ErwanVercruysse/arachne-18/bam_data/swing/2026-09-27_13h23m52_60g_plus_side_clipped/plot.png

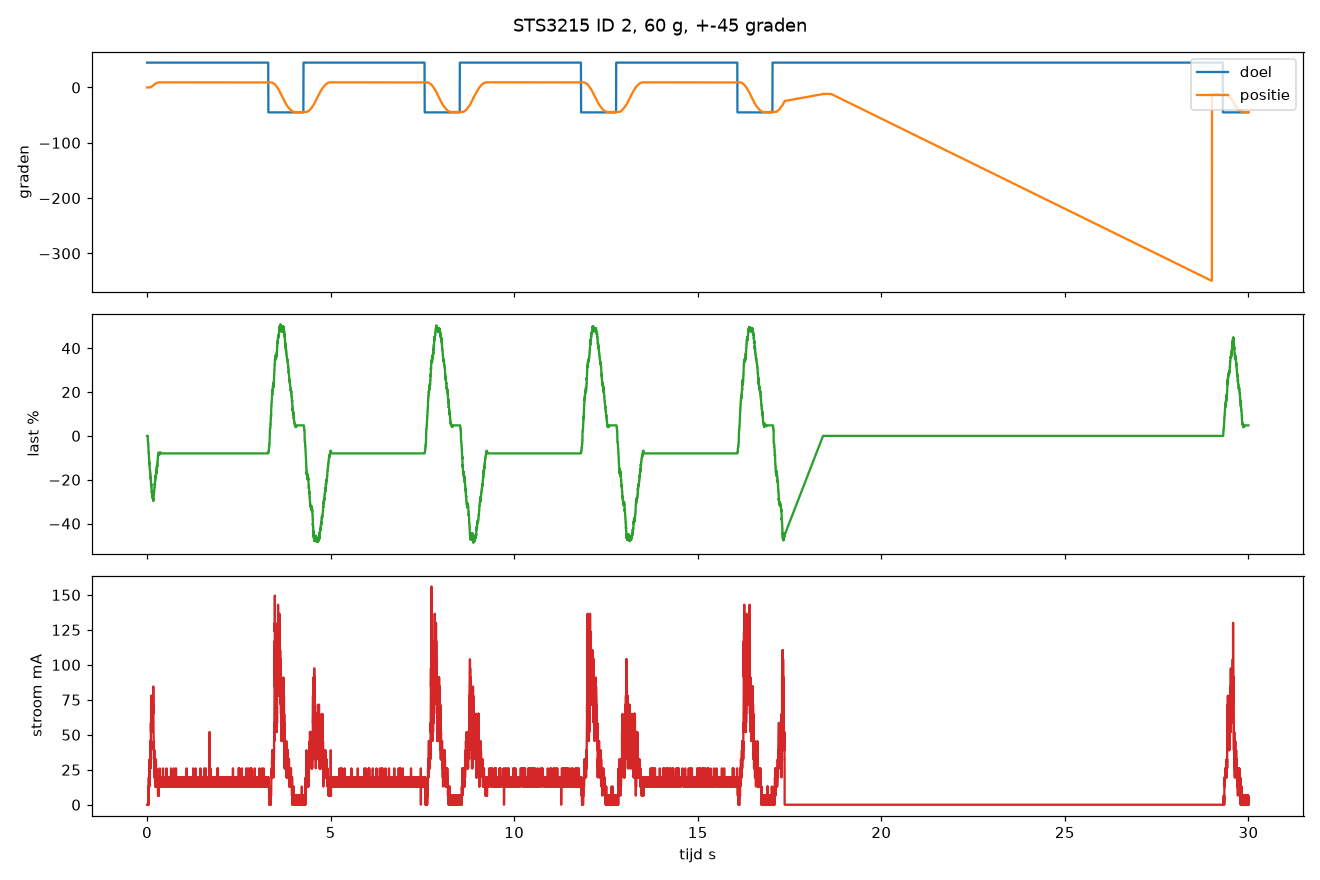
bam_data/swing/2026-09-27_13h23m52_60g_plus_side_clipped/plot.png
