ErwanVercruysse/arachne-18/bam_data/swing/2026-09-27_13h28m05_60g/plot.png

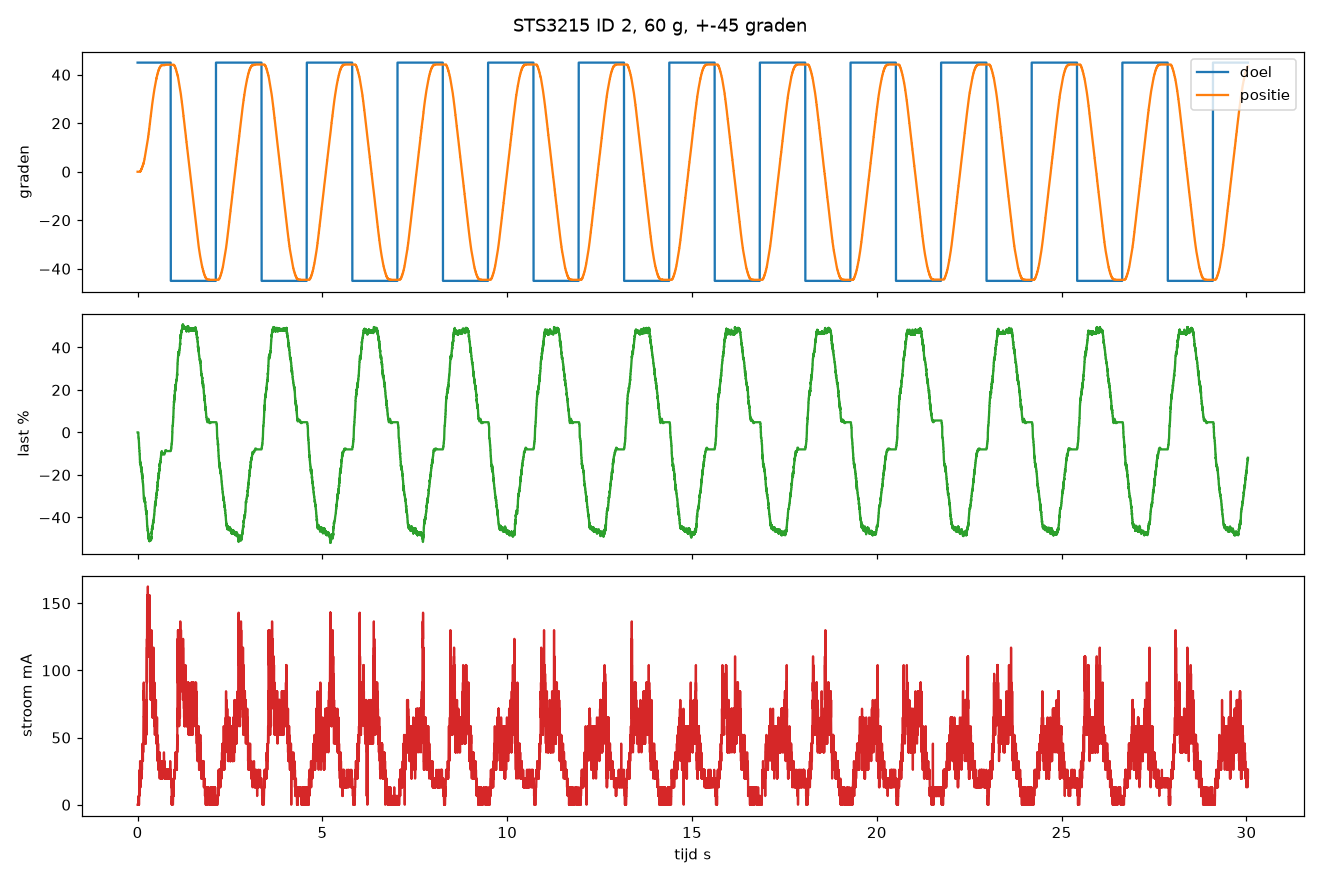
bam_data/swing/2026-09-27_13h28m05_60g/plot.png
