ErwanVercruysse/arachne-18/bam_data/swing/2026-09-27_13h29m40_60g_lift90_WRONG_DIRECTION_STALL/plot.png

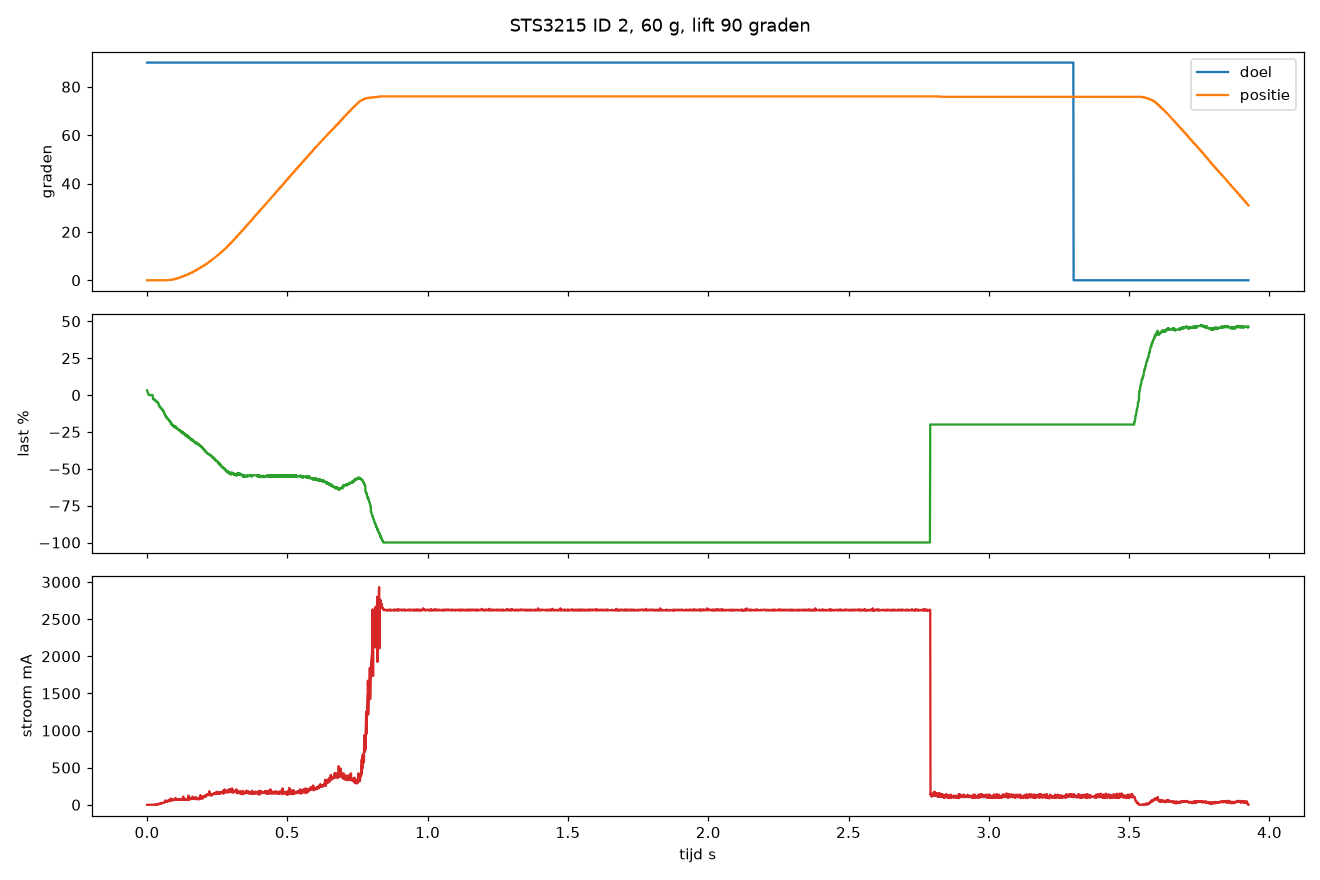
bam_data/swing/2026-09-27_13h29m40_60g_lift90_WRONG_DIRECTION_STALL/plot.png
