ErwanVercruysse/arachne-18/bam_data/swing/2026-09-27_13h41m15_38g_between-95_POWER_CUTOUT/plot.png

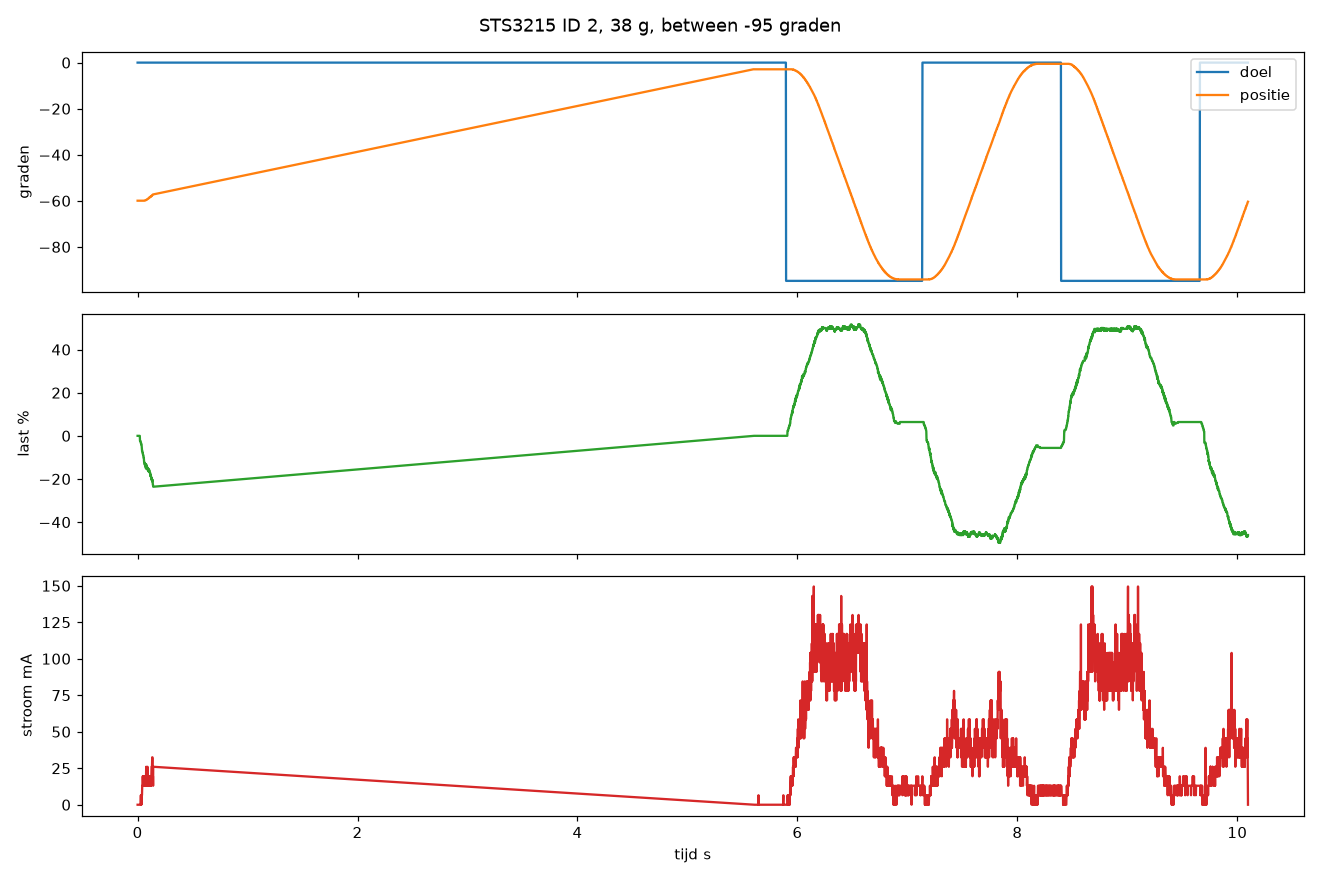
bam_data/swing/2026-09-27_13h41m15_38g_between-95_POWER_CUTOUT/plot.png
