ErwanVercruysse/arachne-18/bam_data/swing/2026-09-27_13h56m46_123g_between-95/plot.png

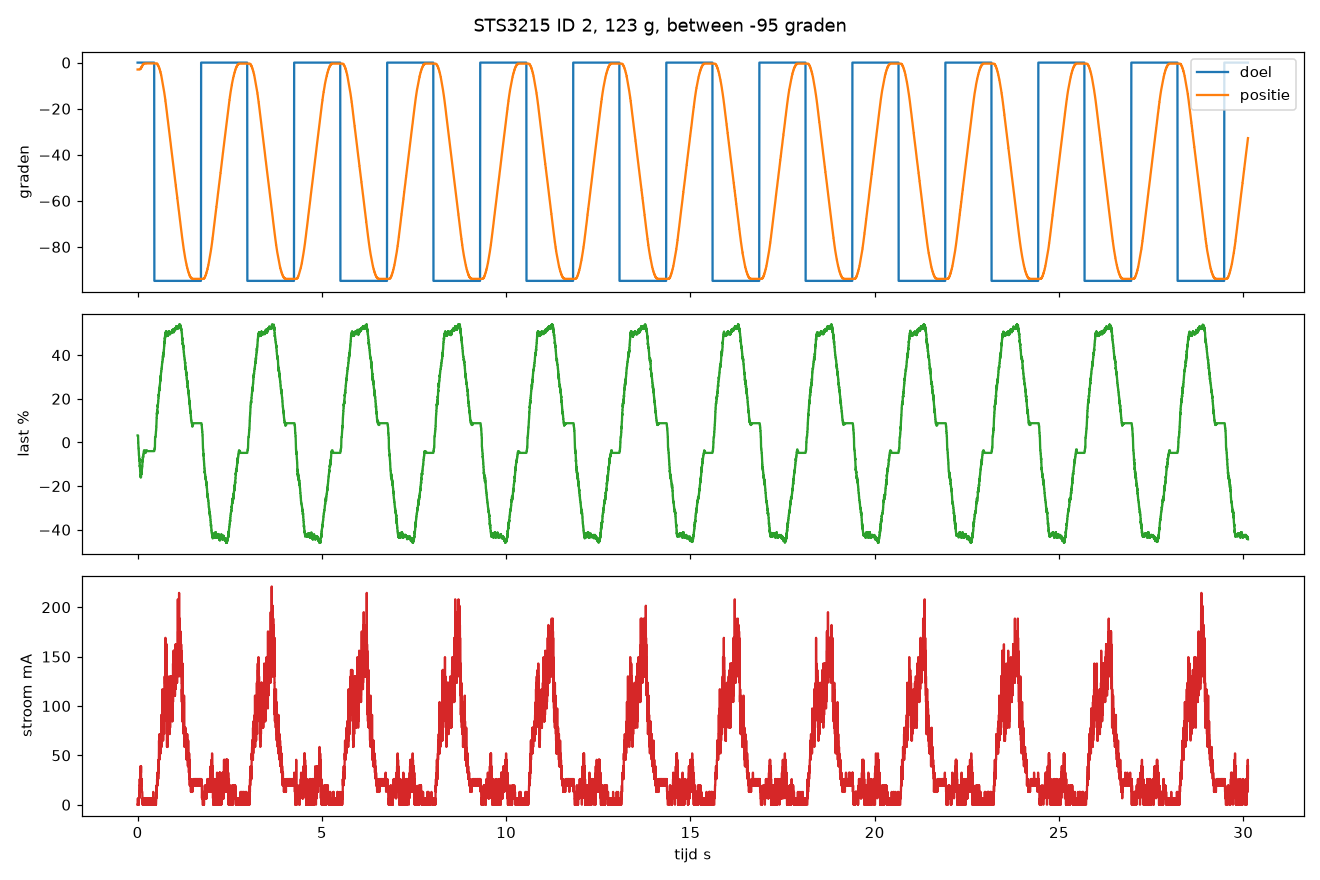
bam_data/swing/2026-09-27_13h56m46_123g_between-95/plot.png
