ErwanVercruysse/arachne-18/bam_data/swing/2026-09-27_13h58m39_148g_between-95/plot.png

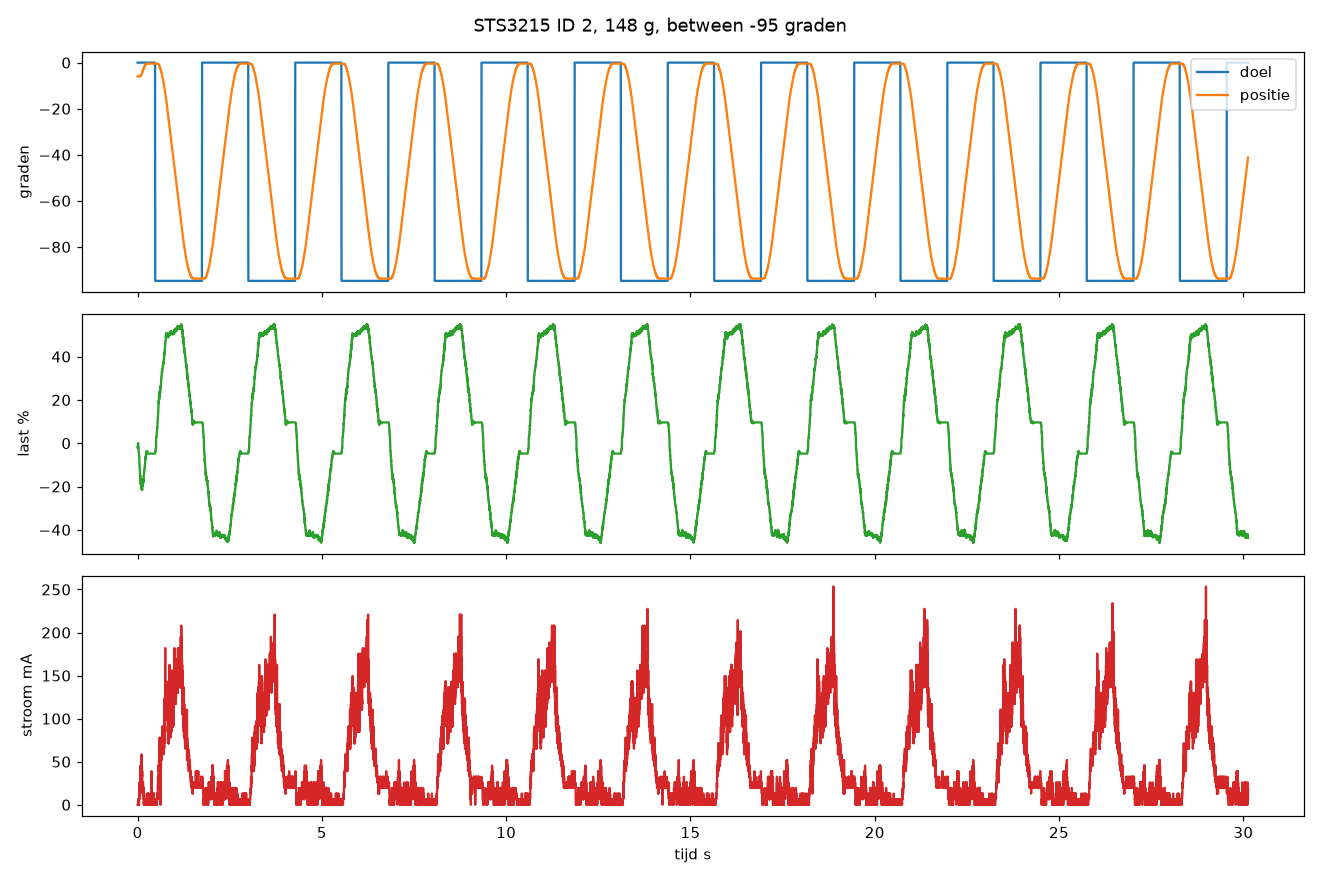
bam_data/swing/2026-09-27_13h58m39_148g_between-95/plot.png
