ErwanVercruysse/arachne-18/bam_data/swing/2026-09-27_14h05m58_317g_between-95_BLOCKED/plot.png

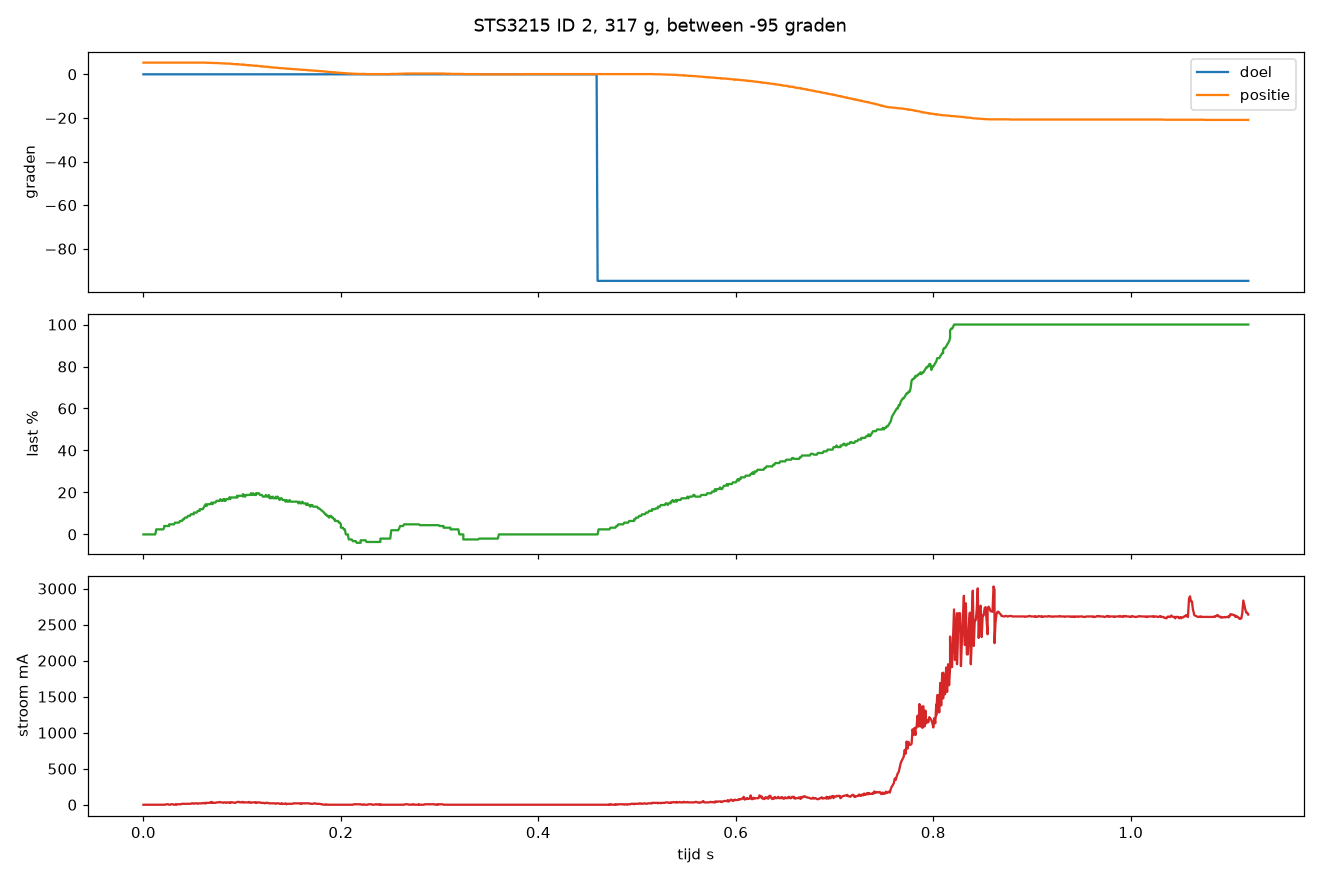
bam_data/swing/2026-09-27_14h05m58_317g_between-95_BLOCKED/plot.png
