ErwanVercruysse/arachne-18/bam_data/swing/2026-09-27_14h06m25_317g_between-95_LOAD_MOVING/plot.png

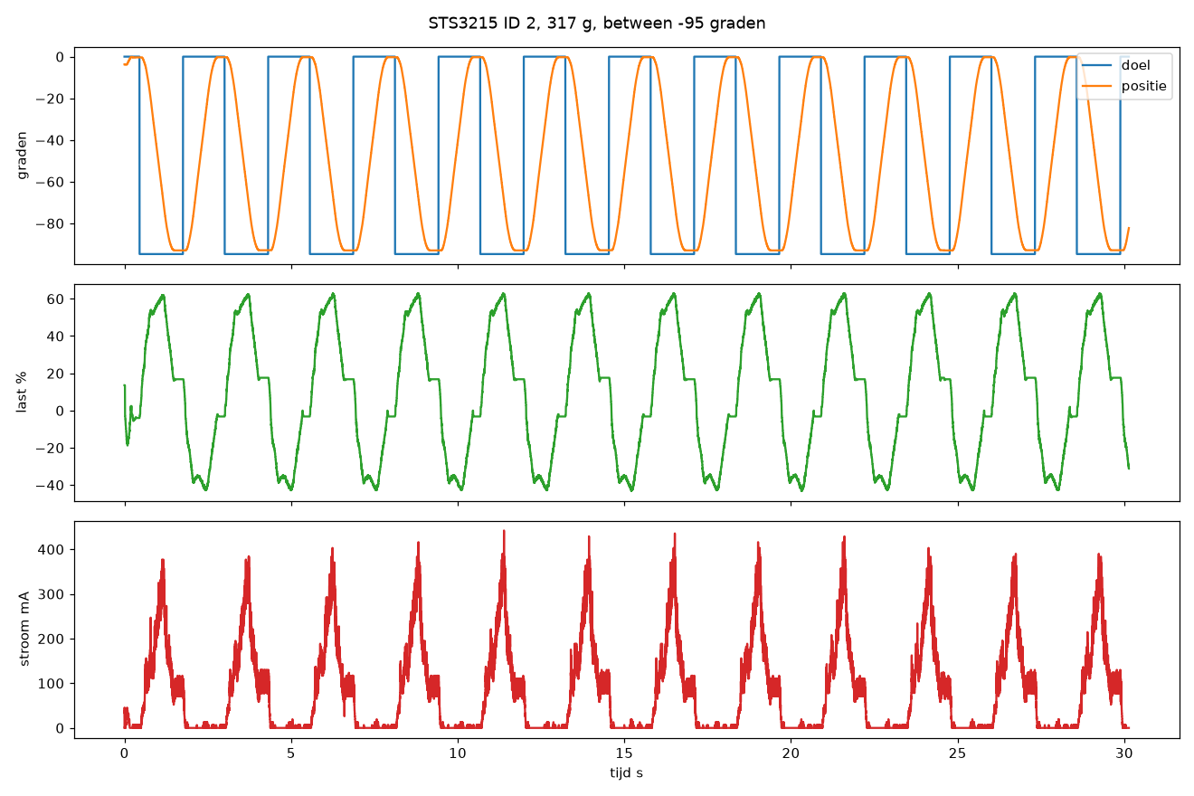
bam_data/swing/2026-09-27_14h06m25_317g_between-95_LOAD_MOVING/plot.png
