ErwanVercruysse/arachne-18/bam_data/swing/2026-09-27_14h07m31_317g_between-95/plot.png

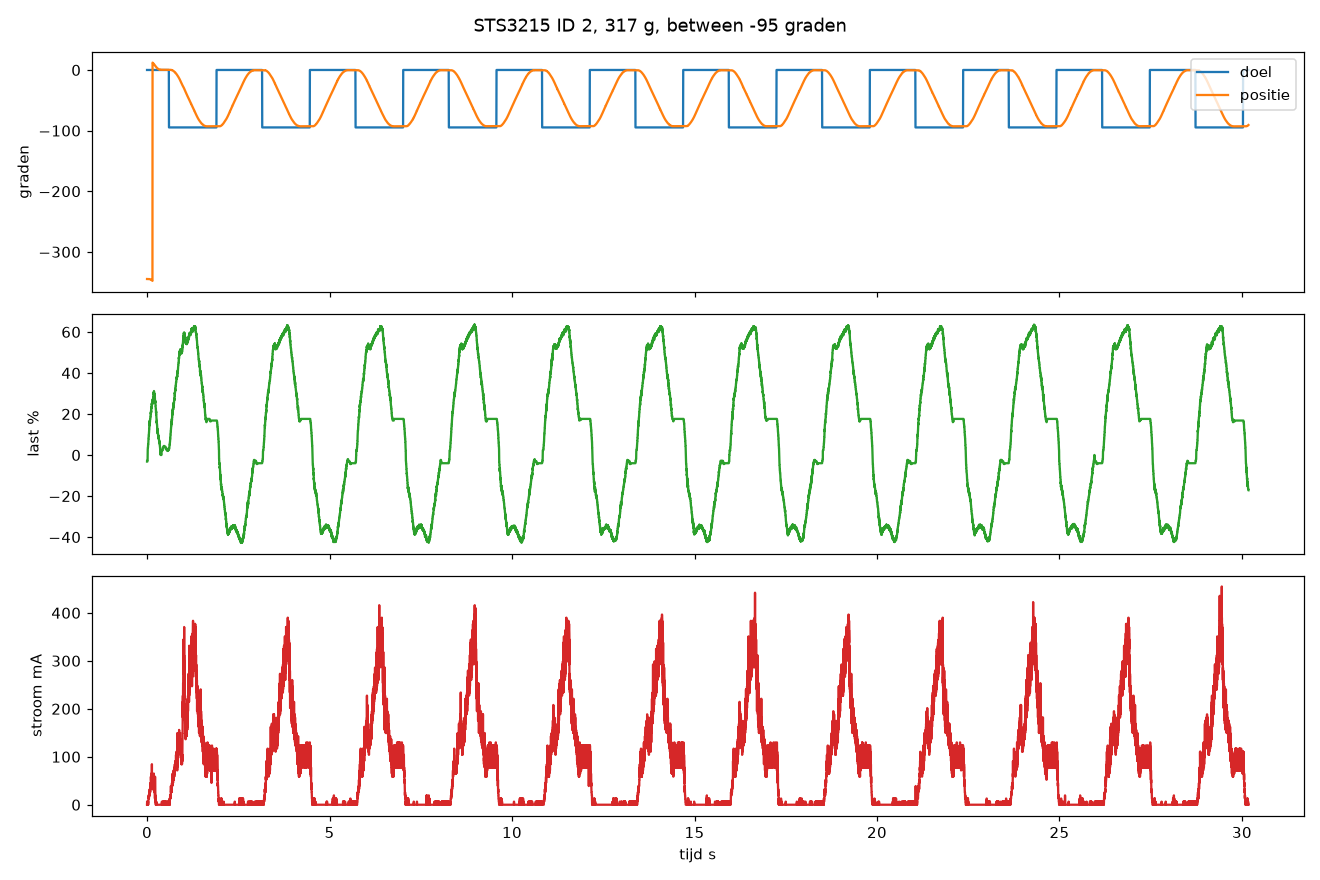
bam_data/swing/2026-09-27_14h07m31_317g_between-95/plot.png
