ErwanVercruysse/arachne-18/bam_data/swing/2026-09-27_14h18m34_432g_between-95_TIMEOUTS/plot.png

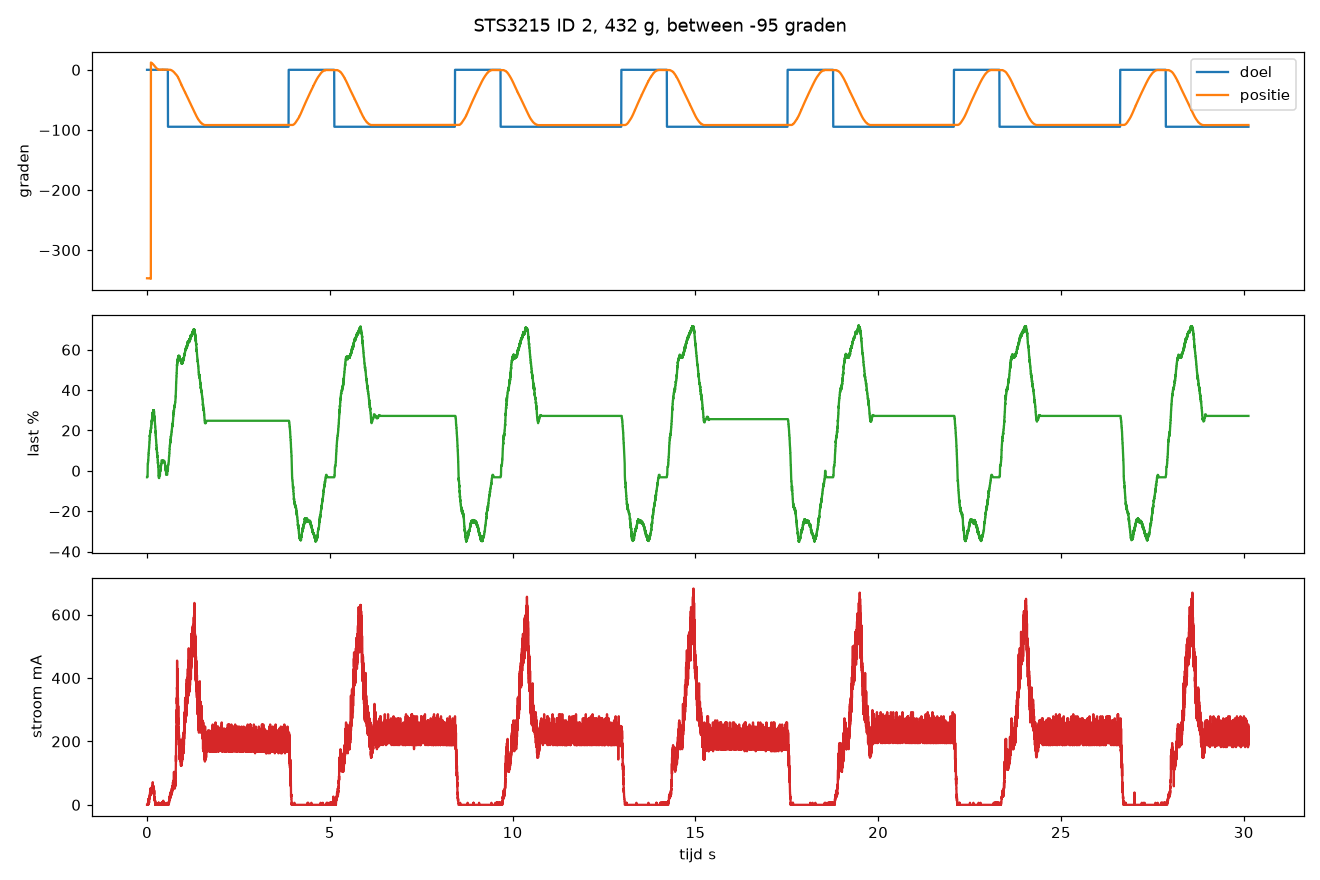
bam_data/swing/2026-09-27_14h18m34_432g_between-95_TIMEOUTS/plot.png
