ErwanVercruysse/arachne-18/bam_data/swing/2026-09-27_14h25m06_462g_between-95/plot.png

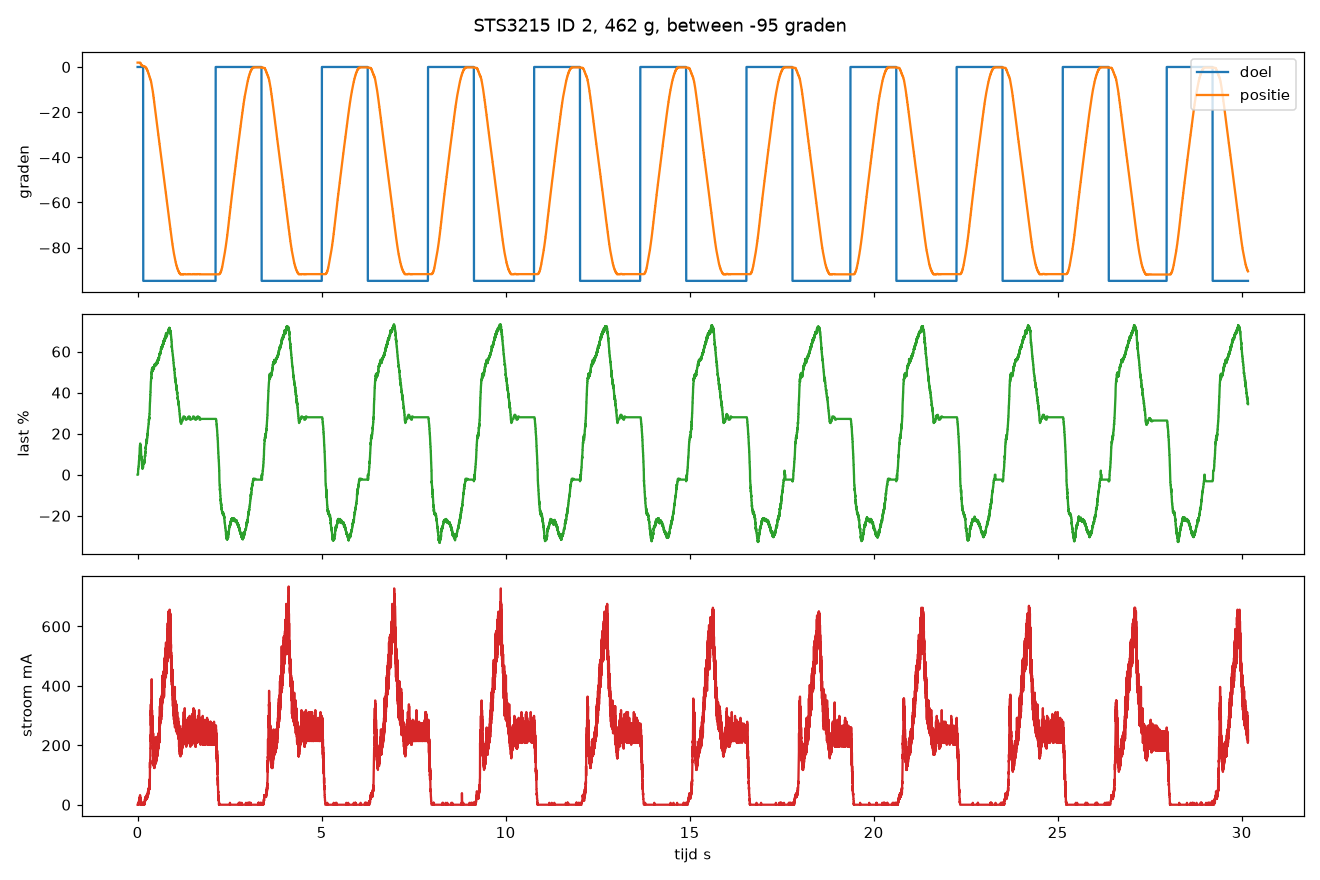
bam_data/swing/2026-09-27_14h25m06_462g_between-95/plot.png
