ErwanVercruysse/arachne-18/cad/brain_mini/fab/render_3d.png

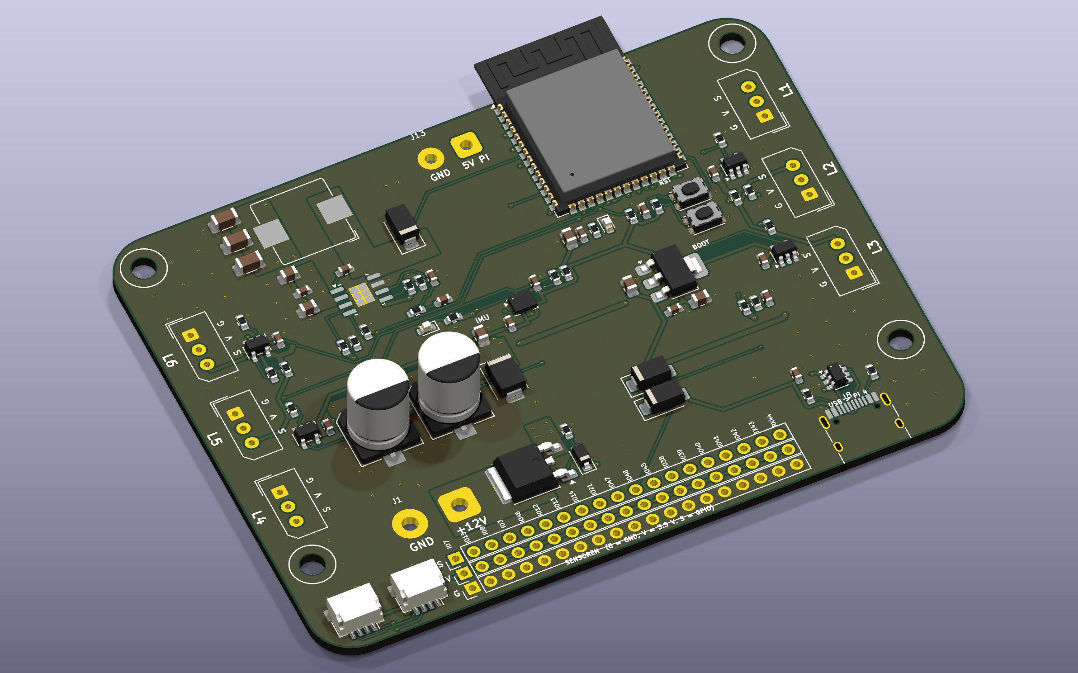
cad/brain_mini/fab/render_3d.png
