ErwanVercruysse/arachne-18/cad/brain_mini/fab/render_bottom.png

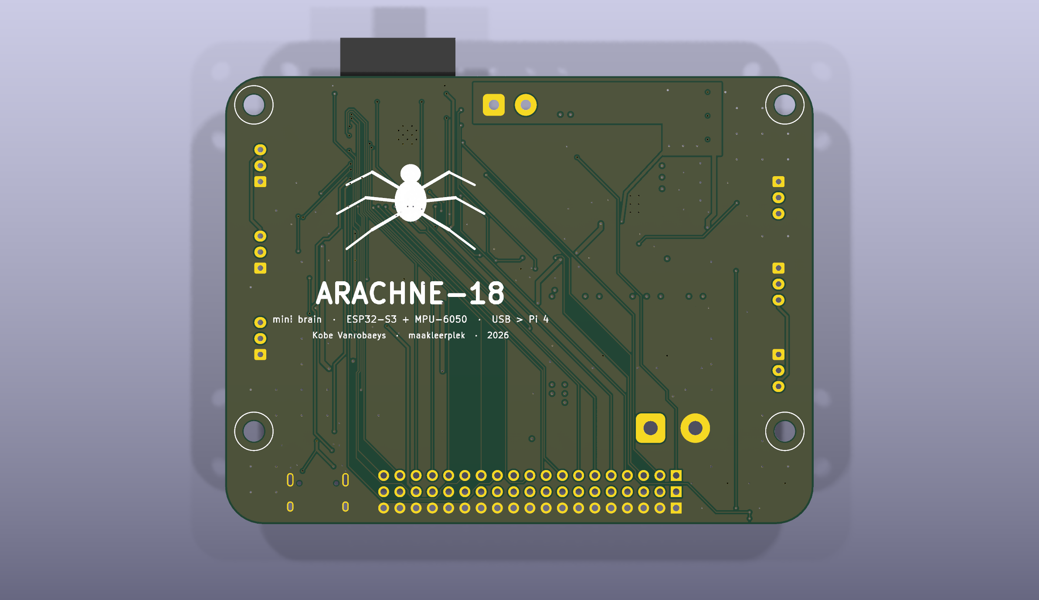
cad/brain_mini/fab/render_bottom.png
