ErwanVercruysse/arachne-18/cad/brain_mini/fab/render_top.png

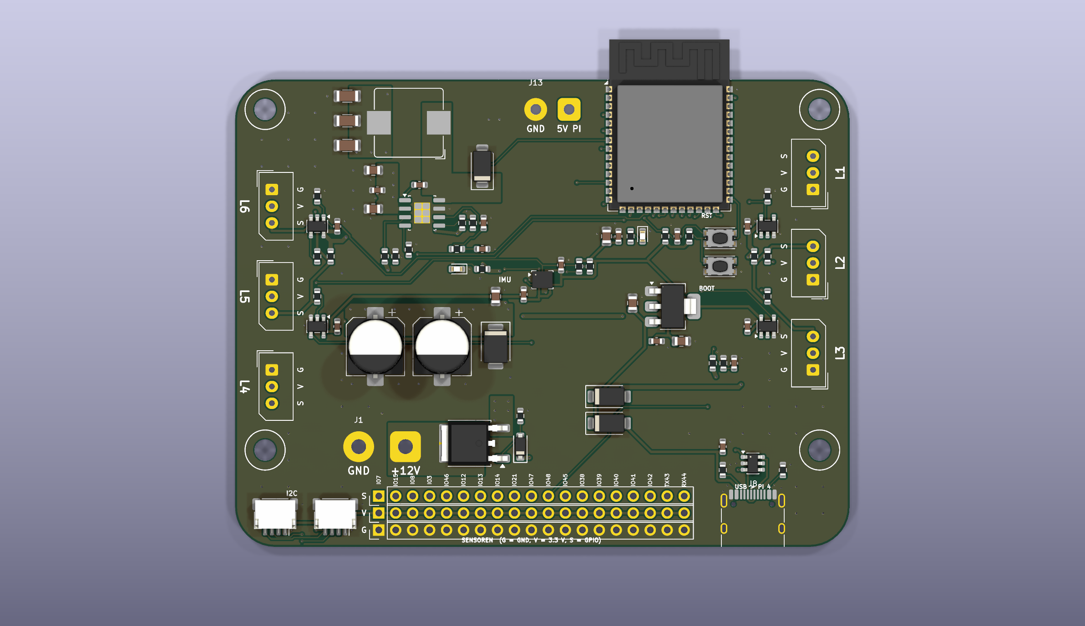
cad/brain_mini/fab/render_top.png
