ErwanVercruysse/arachne-18/cad/brain_pcb/fab/render_3d.png

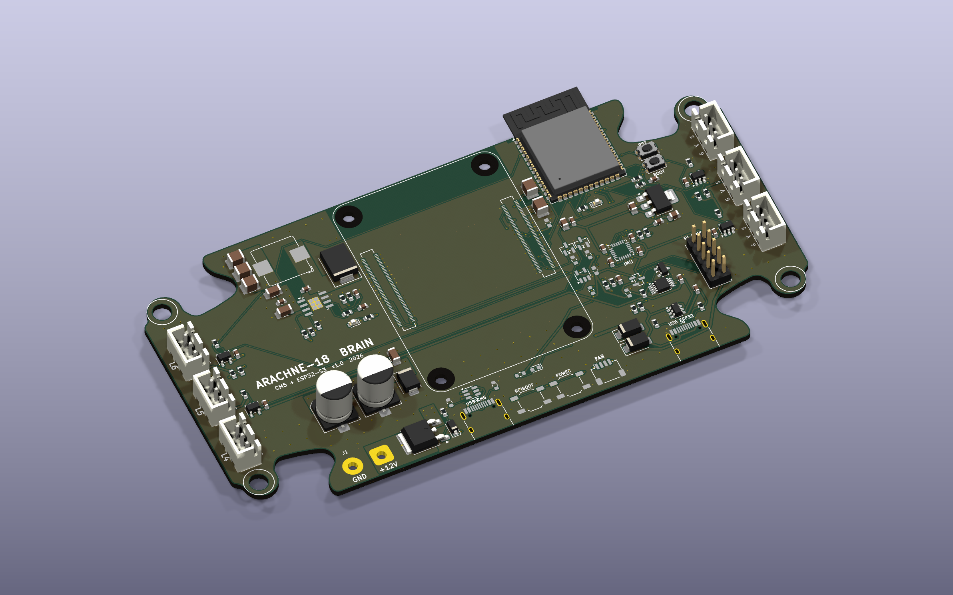
cad/brain_pcb/fab/render_3d.png
