ErwanVercruysse/arachne-18/cad/brain_pcb/fab/render_bottom.png

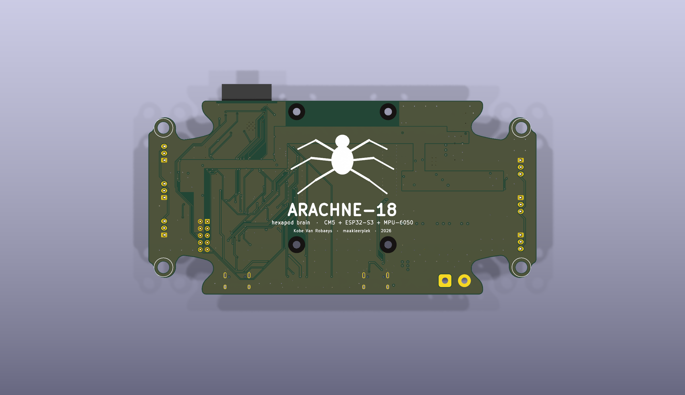
cad/brain_pcb/fab/render_bottom.png
