ErwanVercruysse/arachne-18/cad/brain_pcb/fab/render_top.png

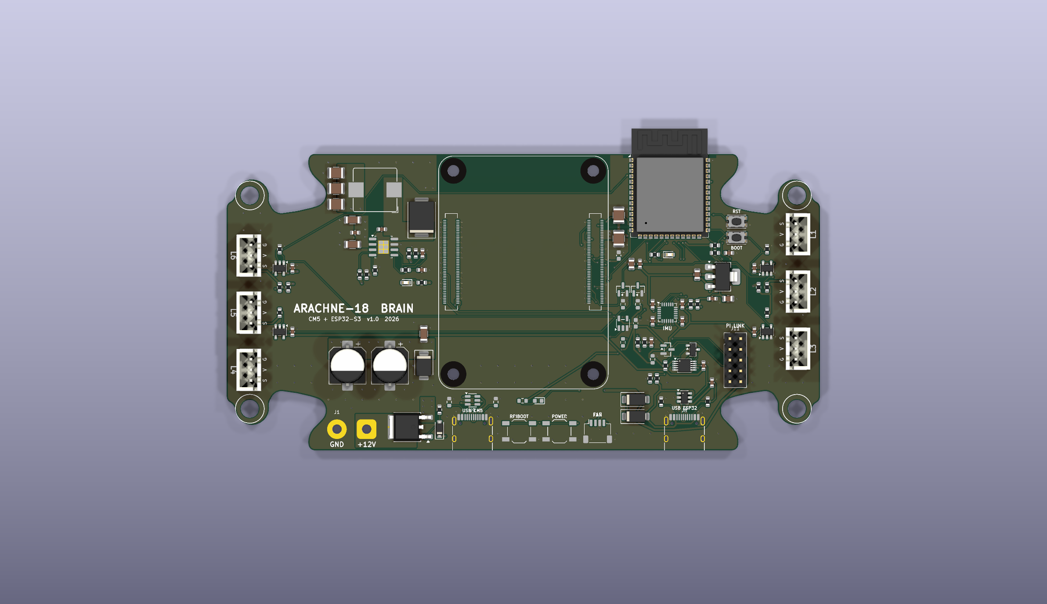
cad/brain_pcb/fab/render_top.png
