ErwanVercruysse/arachne-18/cad/electronics_plate/electronics_plate_preview.png

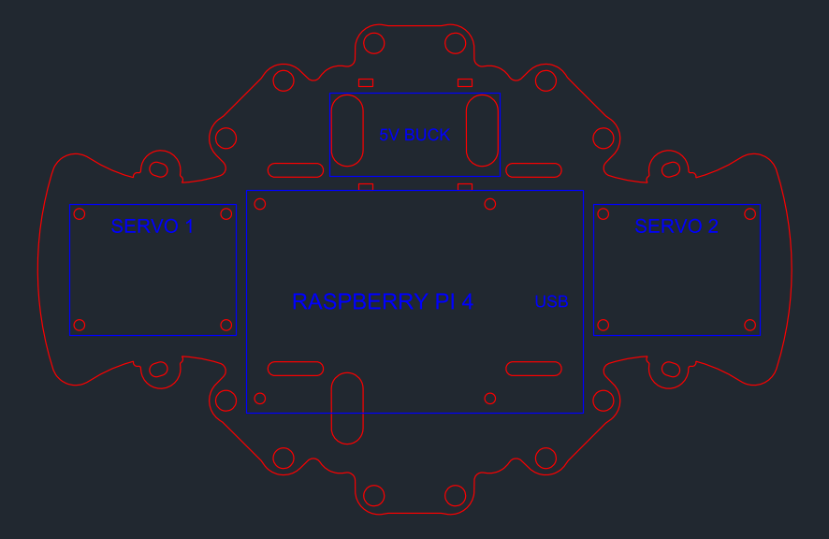
cad/electronics_plate/electronics_plate_preview.png
