ErwanVercruysse/arachne-18/cad/brain_pcb/fab/arachne_brain_BOM_JLCPCB.csv

Comment | Designator | Footprint | Quantity | MPN / note | LCSC Part #
12V IN | J1 | SolderWire_2pad_P7mm_D2.2mm | 1 | solder pads for 14-16 AWG | (solder pads, no part)
AOD4185 | Q1 | TO-252-2 | 1 | AOD4185 (P-MOSFET 40 V 40 A, reverse polarity) | C400894
10k | R1,R11,R12,R17,R18,R21,R22,R29,R31 | R_0603_1608Metric | 9 | 0603 10k 1% | C25804
BZT52C15 | D2 | D_SOD-123 | 1 | BZT52C15 (gate clamp) | C173427
SMBJ15CA | D1 | D_SMB | 1 | SMBJ15CA | C78410
330u 25V | C1,C2 | CP_Elec_8x10.5 | 2 | 330uF 25V 8x10.5 alu | C350008
10u 25V | C3,C5,C6 | C_1206_3216Metric | 3 | 1206 10u 25V X5R ceramic | C9807
100k | R2 | R_0603_1608Metric | 1 | 0603 100k 1% | C25803
15k | R3 | R_0603_1608Metric | 1 | 0603 15k 1% | C22809
100n | C4,C7,C8,C16,C18,C20,C21,C22,C23,C24,C26,C30 | C_0603_1608Metric | 12 | 0603 100n X7R ceramic | C14663
TPS54560B | U1 | Texas_R-PDSO-G8_EP2.95x4.9mm_Mask2.4x3.1mm_ThermalVias | 1 | TPS54560BDDAR | C1850354
442k | R4 | R_0603_1608Metric | 1 | 0603 442k 1% | C23175
90.9k | R5 | R_0603_1608Metric | 1 | 0603 90.9k 1% | C23129
243k | R6 | R_0603_1608Metric | 1 | 0603 243k 1% | C23351
6.8u | L1 | L_Bourns_SRP1038C_10.0x10.0mm | 1 | Bourns SRP1038C-6R8M (6.8 uH, >= 8 A) | C20804570
B560C | D4 | D_SMC | 1 | B560C (5 A 60 V Schottky) | C85100
47u 10V | C9,C10,C11,C31,C32 | C_1210_3225Metric | 5 | 1210 47u 10V X5R ceramic | C84494
53.6k | R7 | R_0603_1608Metric | 1 | 0603 53.6k 1% | C23074
10.2k | R8 | R_0603_1608Metric | 1 | 0603 10.2k 1% | C22772
16.9k | R9 | R_0603_1608Metric | 1 | 0603 16.9k 1% | C25954
4n7 | C12 | C_0603_1608Metric | 1 | 0603 4n7 X5R ceramic | C53987
47p | C13 | C_0603_1608Metric | 1 | 0603 47p X7R ceramic | C1671
groen 5V | D5 | LED_0603_1608Metric | 1 | LED 0603 green | C12624
2k2 | R10 | R_0603_1608Metric | 1 | 0603 2k2 1% | C4190
SS14 | D6,D7 | D_SMA | 2 | SS14 | C2480
AMS1117-3.3 | U2 | SOT-223-3_TabPin2 | 1 | AMS1117-3.3 | C6186
10u | C14 | C_0805_2012Metric | 1 | 0805 10u X5R ceramic | C15850
22u | C15,C17 | C_0805_2012Metric | 2 | 0805 22u X5R ceramic | C29277
ESP32-S3-WROOM-1-N16R8 | U3 | ESP32-S3-WROOM-1 | 1 | ESP32-S3-WROOM-1-N16R8 | C2913202
1u | C19,C29 | C_0603_1608Metric | 2 | 0603 1u X5R ceramic | C15849
RESET | SW1 | SW_Push_1P1T_NO_CK_KMR2 | 1 | CK KMR221G (4.2x2.8 tact) | C72443
BOOT | SW2 | SW_Push_1P1T_NO_CK_KMR2 | 1 | CK KMR221G (4.2x2.8 tact) | C72443
blauw ESP | D8 | LED_0603_1608Metric | 1 | LED 0603 blue | C2288
1k | R15,R19,R23 | R_0603_1608Metric | 3 | 0603 1k 1% | C21190
74AHCT1G126 | U4,U6 | SOT-23-5 | 2 | 74AHCT1G126GW (TX driver, 5 V out) | C163712
74LVC1G34 | U5,U7 | SOT-23-5 | 2 | 74LVC1G34GW (RX buffer, 5 V tolerant) | C840096
47 | R16,R20 | R_0603_1608Metric | 2 | 0603 47 1% | C23182
L1 servo | J2 | Molex_5268-03A_1x03_P2.50mm_Vertical | 1 | Molex 5268-03A (5264 mating, Feetech bus) | C225432 (A2505WV-3P)
L2 servo | J3 | Molex_5268-03A_1x03_P2.50mm_Vertical | 1 | Molex 5268-03A (5264 mating, Feetech bus) | C225432 (A2505WV-3P)
L3 servo | J4 | Molex_5268-03A_1x03_P2.50mm_Vertical | 1 | Molex 5268-03A (5264 mating, Feetech bus) | C225432 (A2505WV-3P)
L4 servo | J5 | Molex_5268-03A_1x03_P2.50mm_Vertical | 1 | Molex 5268-03A (5264 mating, Feetech bus) | C225432 (A2505WV-3P)
L5 servo | J6 | Molex_5268-03A_1x03_P2.50mm_Vertical | 1 | Molex 5268-03A (5264 mating, Feetech bus) | C225432 (A2505WV-3P)
L6 servo | J7 | Molex_5268-03A_1x03_P2.50mm_Vertical | 1 | Molex 5268-03A (5264 mating, Feetech bus) | C225432 (A2505WV-3P)
MPU-6050 | U8 | InvenSense_QFN-24_4x4mm_P0.5mm | 1 | MPU-6050 | C24112
2n2 | C25 | C_0603_1608Metric | 1 | 0603 2n2 X5R ceramic | C1604
10n | C27 | C_0603_1608Metric | 1 | 0603 10n X7R ceramic | C57112
4k7 | R24,R25 | R_0603_1608Metric | 2 | 0603 4k7 1% | C23162
USB-C ESP32 | J8 | USB_C_Receptacle_HRO_TYPE-C-31-M-12 | 1 | HRO TYPE-C-31-M-12 | C165948
5k1 | R27,R28 | R_0603_1608Metric | 2 | 0603 5k1 1% | C23186
USBLC6-2SC6 | U10 | SOT-23-6 | 1 | USBLC6-2SC6 | C2687116
20k | R30 | R_0603_1608Metric | 1 | 0603 20k 1% | C4184
FSUSB42MUX | U11 | MSOP-10_3x3mm_P0.5mm | 1 | FSUSB42MUX (SEL=0: CM5, SEL=1: USB-C) | C11355
2N7002 | Q5 | SOT-23 | 1 | 2N7002 | C8545
PI LINK | J11 | PinHeader_2x05_P2.54mm_Vertical | 1 | 2x5 pin header 2.54 (= Pi header pins 1-10) | C492422
