ErwanVercruysse/arachne-18/cad/bam_rig/bam_arm_plate.step

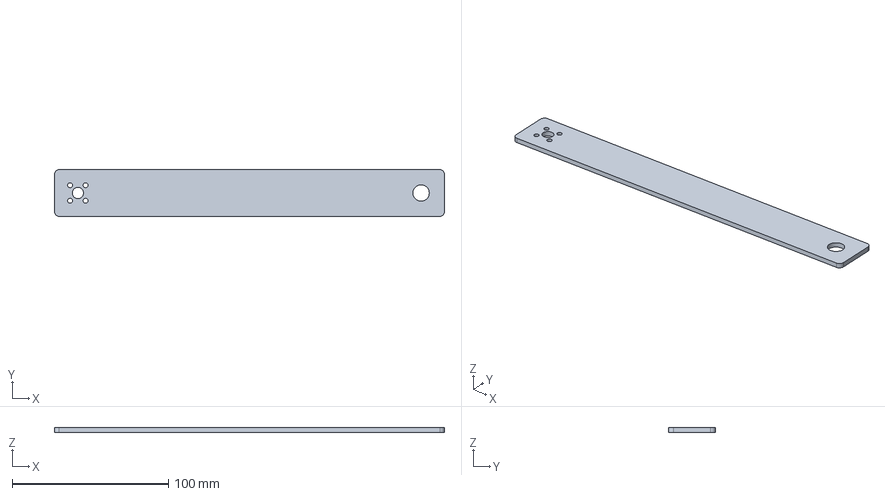
[picture p25: CAD file, 2026-10-16]
cad/bam_rig/bam_arm_plate.step
250.0 x 30.0 x 3.00 mm
