ErwanVercruysse/arachne-18/cad/electronics_plate/electronics_plate_v4.dxf

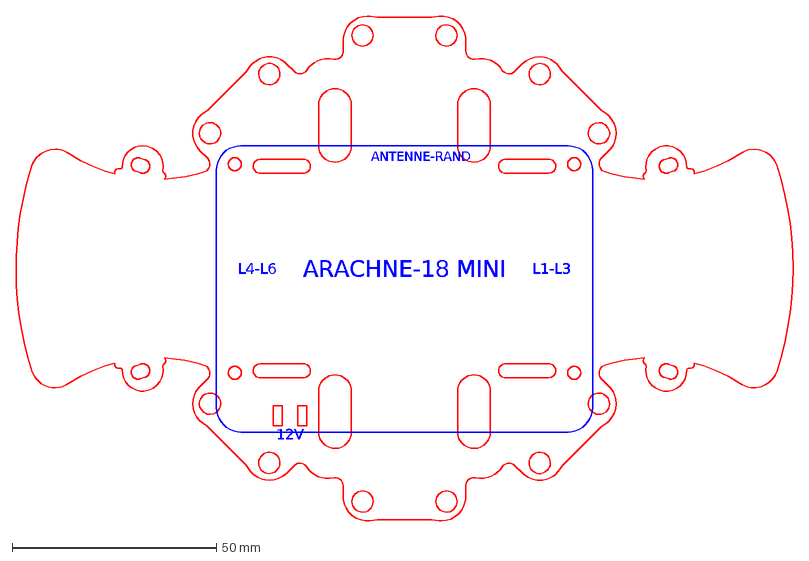
[picture p26: CAD file, 2026-10-18]
cad/electronics_plate/electronics_plate_v4.dxf
ARACHNE-18 MINI
ANTENNE-RAND
L1-L3
L4-L6
12V
