ErwanVercruysse/arachne-18/cad/electronics_plate/ref/01_chassis_built.stl

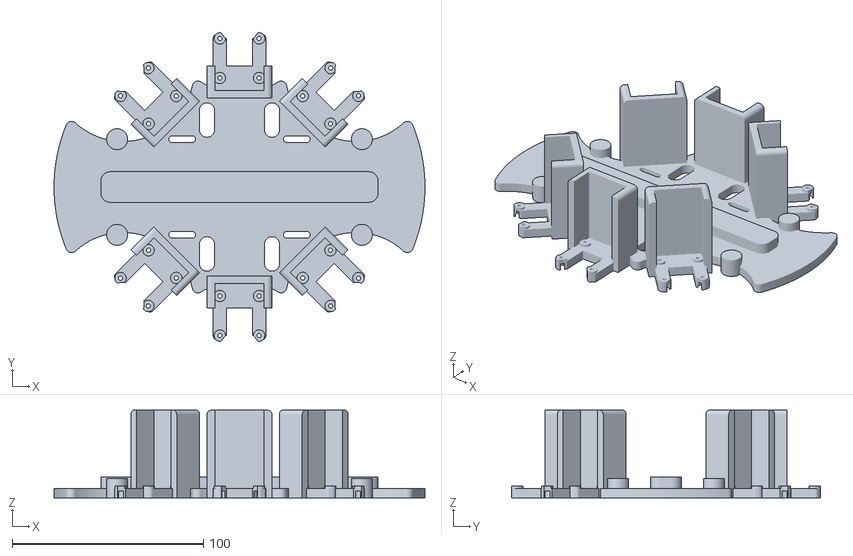
[picture p27: CAD file, 2026-10-16]
cad/electronics_plate/ref/01_chassis_built.stl
194.0 x 161.4 x 45.8
