ErwanVercruysse/arachne-18/cad/bam_rig/bam_pendulum_arm.step

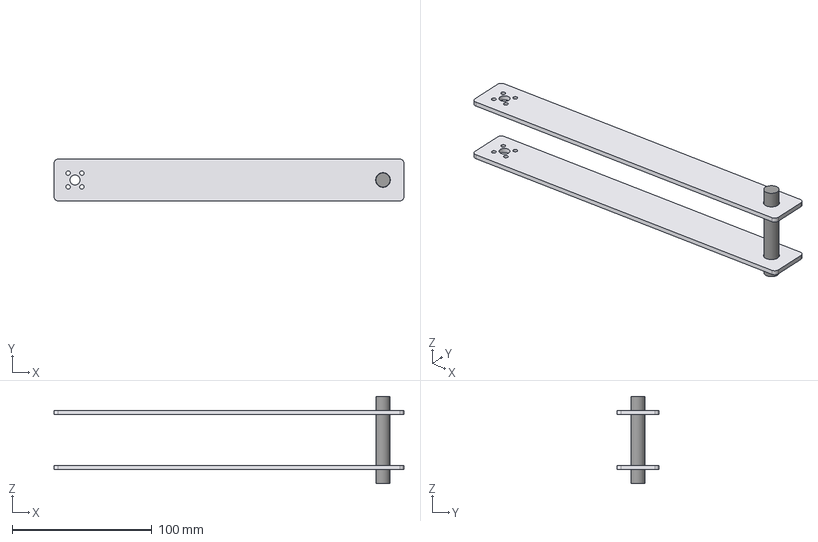
[picture p28: CAD file, 2026-10-16]
cad/bam_rig/bam_pendulum_arm.step
250.0 x 30.0 x 62.5 mm
plate_driven
plate_dummy
m10_bolt_reference
