ErwanVercruysse/arachne-18/cad/bam_rig/bam_arm_plates.dxf

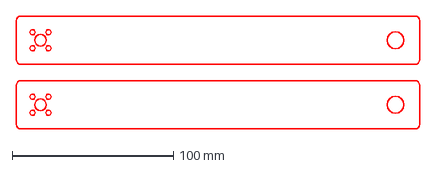
[picture p29: CAD file, 2026-10-16]
cad/bam_rig/bam_arm_plates.dxf
250.0 x 70.0 mm
