ErwanVercruysse/arachne-18/cad/electronics_plate/electronics_plate_v3.dxf

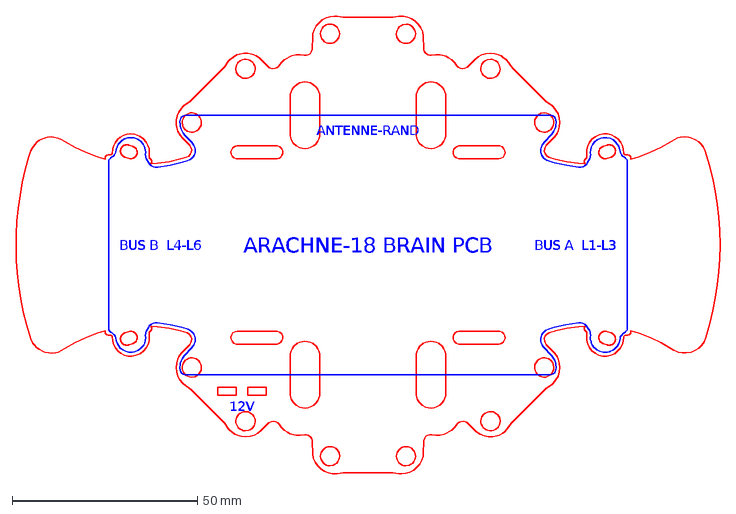
[picture p30: CAD file, 2026-10-17, an earlier design]
cad/electronics_plate/electronics_plate_v3.dxf
ARACHNE-18 BRAIN PCB
ANTENNE-RAND
BUS A L1-L3
BUS B L4-L6
12V
