ErwanVercruysse/arachne-18/cad/electronics_plate/electronics_plate.dxf

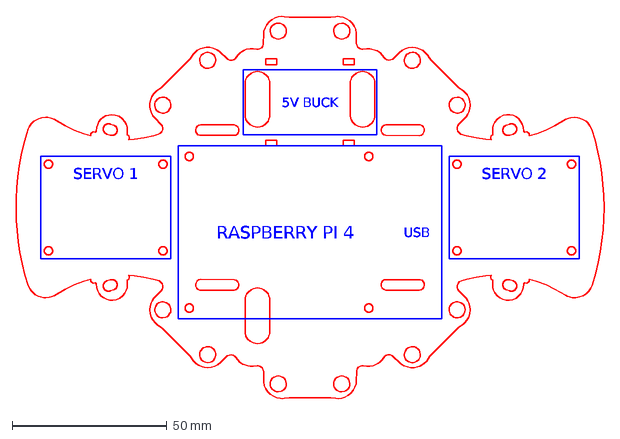
[picture p31: CAD file, 2026-10-16, an earlier design]
cad/electronics_plate/electronics_plate.dxf
SERVO 1
SERVO 2
RASPBERRY PI 4
USB
5V BUCK
