ErwanVercruysse/arachne-18/cad/brain_pcb/tools/sexp.py

"""Minimal S-expression reader/writer for KiCad files (symbols, schematics)."""
import re

_TOK = re.compile(r'\s*(?:(\()|(\))|("(?:[^"\\]|\\.)*")|([^\s()"]+))', re.S)


class Sym(str):
    """Unquoted atom."""


def parse(text):
    stack, cur = [], []
    pos = 0
    n = len(text)
    while pos < n:
        m = _TOK.match(text, pos)
        if not m:
            if text[pos:].strip() == '':
                break
            raise ValueError('bad sexp at %d' % pos)
        pos = m.end()
        lp, rp, s, a = m.groups()
        if lp:
            stack.append(cur); cur = []
        elif rp:
            done = cur; cur = stack.pop(); cur.append(done)
        elif s is not None:
            cur.append(s[1:-1].replace('\\"', '"').replace('\\\\', '\\'))
        elif a is not None:
            cur.append(Sym(a))
    return cur[0] if len(cur) == 1 else cur


def q(s):
    return '"' + str(s).replace('\\', '\\\\').replace('"', '\\"') + '"'


def dump(x, ind=0):
    if isinstance(x, list):
        if not x:
            return '()'
        simple = all(not isinstance(e, list) for e in x)
        if simple:
            return '(' + ' '.join(dump(e) for e in x) + ')'
        out = '(' + dump(x[0])
        for e in x[1:]:
            if isinstance(e, list):
                out += '\n' + '\t' * (ind + 1) + dump(e, ind + 1)
            else:
                out += ' ' + dump(e)
        return out + '\n' + '\t' * ind + ')'
    if isinstance(x, Sym):
        return str(x)
    if isinstance(x, bool):
        return 'yes' if x else 'no'
    if isinstance(x, (int, float)):
        v = round(float(x), 4)
        return ('%d' % v) if v == int(v) else ('%.4f' % v).rstrip('0')
    return q(x)


def find(node, key):
    return [e for e in node if isinstance(e, list) and e and e[0] == key]


def find1(node, key):
    r = find(node, key)
    return r[0] if r else None
