ErwanVercruysse/arachne-18/(commit log)

2026-10-16 Kobe: calibration, tools (stand/walk/spin/dance, live twin, browser sim), BAM data, STS3215 firmware, electronics plate
2026-10-17 Brain PCB: CM5/Pi 4 + ESP32-S3 + MPU-6050 4-layer board, acrylic plate v3
    Generated KiCad 10 project (cad/brain_pcb) from tools/design.py: schematic, routed
    board shaped like the chassis, JLCPCB gerbers/BOM/CPL with LCSC numbers. First build
    is the Pi 4 variant (CM5-only parts DNP). DRC/ERC/parity all 0.
2026-10-18 Mini brain board: 92x60 ESP32-S3 + MPU-6050, Pi 4 over USB-C, 5V pads; acrylic plate v4
2026-10-18 Mini board: ignore sub-0.1 mm GND-pour sliver warning, DRC clean
2026-10-18 dance: body bends 2 cm down twice per circle (--dip, --tilt)
2026-10-18 dance: dip defaults to the deepest the joint limits allow (checked on the current pose)
2026-10-18 Mini board: 2x13 GPIO header with all 19 free ESP32-S3 GPIOs + I2C + power, IMU moved
2026-10-18 Mini board: sensor strip (G-V-S per GPIO) on a 10 mm longer bottom edge, 2x Qwiic, USB-C moved to the new edge
2026-10-18 Mini board: servo headers are now Molex Mini-SPOX 5267-03A (chamfered, mates with the 5264 plug), real Molex in the BOM
2026-10-18 Mini board: MPU-6050 moved to the exact robot centre (0,0)
2026-10-21 Name Kobe Vanrobaeys on silkscreen/schematic, fresh JLC fab files for brain_mini
2026-10-21 JLC BOM: one line per LCSC part, solder pads (J1, J13) out of BOM and CPL
2026-10-21 brain_mini v4 price pass: JLC basic parts (buck network, caps, SS54, LEDs), LSM6DS3TR-C IMU, hand-solder parts DNP, JLC rotation corrections in the CPL
2026-10-21 CPL: ESP32-S3 module offset for JLC (pad-field centre, 3.62 mm)
2026-10-21 JLC: every part placed again (no DNP), CPL positions = pad-field centre from the board (fixes USB-C/headers/connectors offset)
2026-10-21 JLC: sensor headers J14-J16 hand-soldered (DNP), TO-252 rotation +180
